MarkLagodych/PPVoting/src/voter/scheme/ESP8266-basic-connection.png

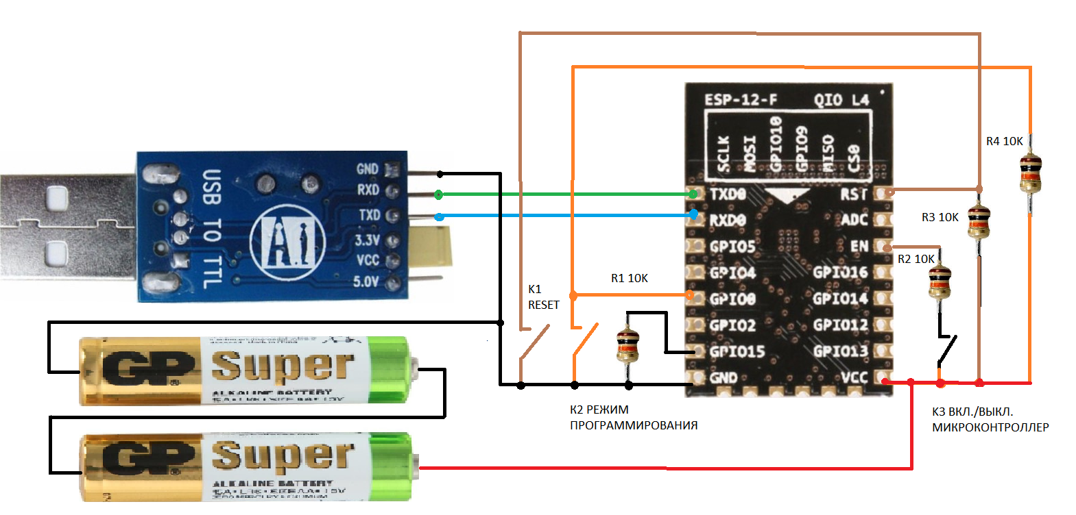
src/voter/scheme/ESP8266-basic-connection.png
