MarkLagodych/PPVoting/(list of files, drawings)

Other design files:
src/voter/schematic/schematic Easy EDA project.json
