MarkLagodych/PPVoting/(commit log)

2021-01-04 new files
    [schematic Easy EDA project.json]
2021-01-04 new file: README.md deleted: src/voter/schematic/schematic with differences in pcb.png deleted: "src/voter/schematic/\320\221\320\265\320\267\321\213\320\274\321\217\320\275\320\275\321\213\320\271.p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
2021-01-04 renamed: src/voter/scheme/ESP8266_12E_pinout.png -> src/voter/scheme/ESP8266-12E-pinout.png renamed: src/voter/scheme/ESP8266_basic_connection.png -> src/voter/scheme/ESP8266-basic-connection.png ren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
2021-01-13 new file: .gitignore new file: bin/driver/PROBLEMS_NOTE.txt deleted: bin/plugin/PPVoting.ppa new file: bin/plugin/PPVoting.ppam modified: bin/plugin/PPVoting_log.txt deleted: bin/plugin/PPVoting_m.pp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
    [server.ino, upload_server.py, uploader.py]
2021-01-23 modified: README.md modified: bin/plugin/PPVoting_config.json modified: bin/plugin/PPVoting_log.txt modified: src/plugin/PPVoting.pptm modified: src/plugin/REFERENCE_NOTE.txt new file: src/plugin/cod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
2021-01-25 modified: bin/plugin/PPVoting.ppam deleted: bin/plugin/PPVoting_config.json modified: src/plugin/PPVoting.pptm modified: src/plugin/code/Base.bas modified: src/plugin/code/Diagram.frm modified: src/p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
2021-02-06 modified: README.md deleted: bin/driver/PROBLEMS_NOTE.txt modified: bin/plugin/PPVoting.ppam deleted: src/plugin/ERRORS_NOTE.txt modified: src/plugin/PPVoting.pptm deleted: src/plugin/REFERENCE_NOTE.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
    [server.ino, settings.h]
2021-02-08 modified: src/plugin/code/Base.bas modified: src/plugin/code/Diagram.frm modified: src/plugin/code/Logging.bas modified: src/plugin/code/PPVotingUI.bas modified: src/plugin/code/Timer.bas modified: s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
2021-04-27 modified: .gitignore new file: demo/PPVoting.docx new file: demo/schemes/common/diagram.svg new file: demo/schemes/common/gears.svg new file: demo/schemes/common/wave.svg new file: demo/schemes/schem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
2021-05-10 new file: demo/PPVoting.pptx modified: src/plugin/PPVoting.pptm modified: src/plugin/code/Timer.bas
2021-05-10 modified: .gitignore deleted: demo/PPVoting.docx deleted: demo/PPVoting.pptx deleted: demo/schemes/common/diagram.svg deleted: demo/schemes/common/gears.svg deleted: demo/schemes/common/wave.svg dele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
2021-05-12 modified: bin/plugin/PPVoting.ppam modified: src/plugin/PPVoting.pptm modified: src/plugin/code/Timer.bas
